JNmeca/Jorge-Nicolas-2019-8448-Electiva-Mecatronica/Resume/ModBus.jpeg

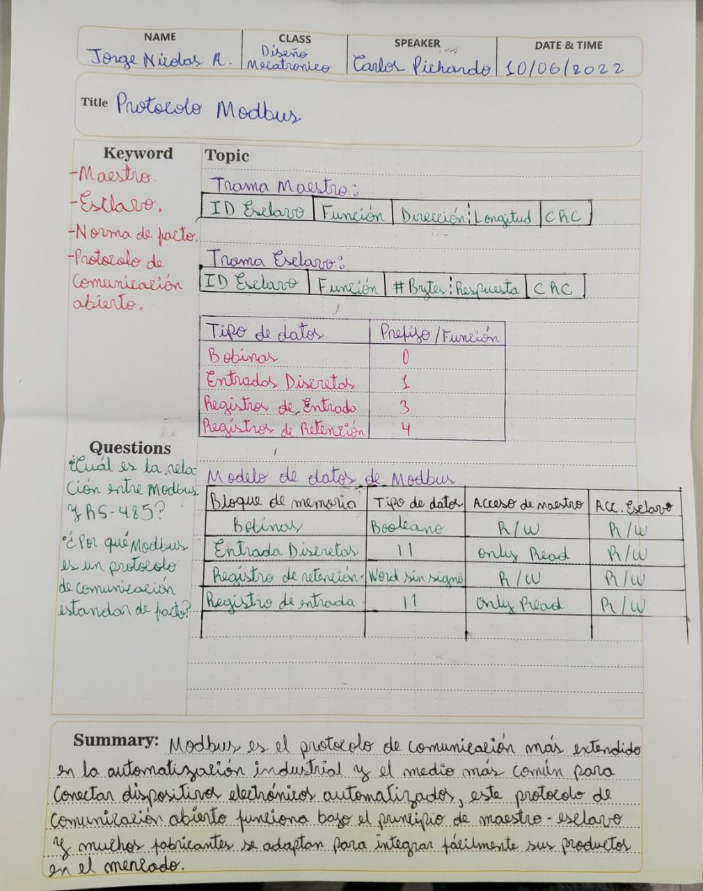
Resume/ModBus.jpeg
