JNmeca/Jorge-Nicolas-2019-8448-Electiva-Mecatronica/Resume/Qg en los MOSFET.jpeg

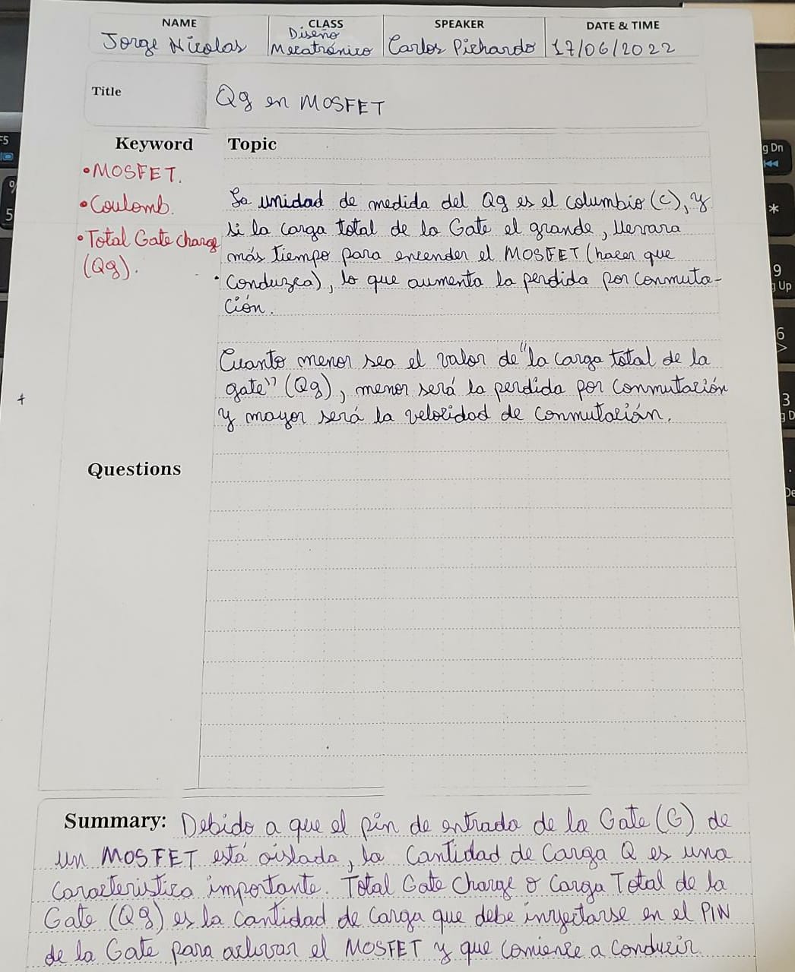
Resume/Qg en los MOSFET.jpeg
