JNmeca/Jorge-Nicolas-2019-8448-Electiva-Mecatronica/Resume/Baudio - BPS.jpeg

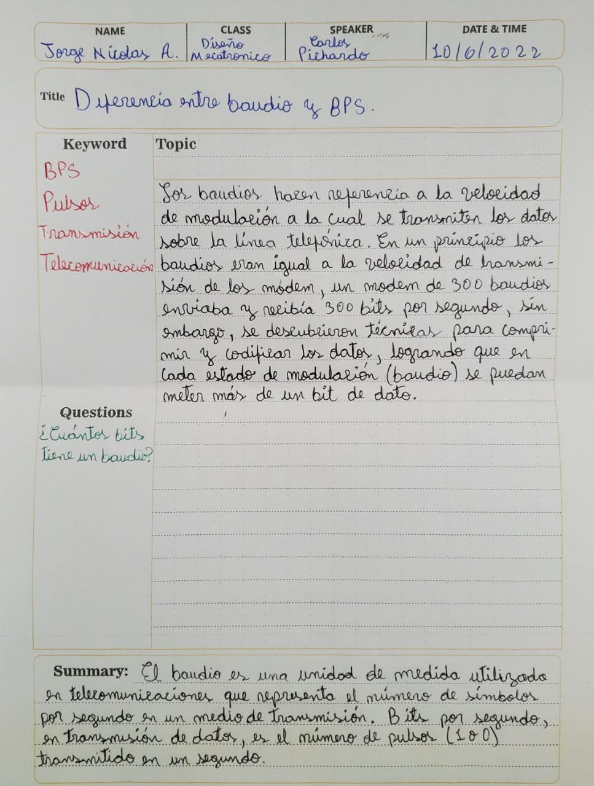
Resume/Baudio - BPS.jpeg
