JNmeca/Jorge-Nicolas-2019-8448-Electiva-Mecatronica/Resume/Dieléctrico en los capacitores.jpeg

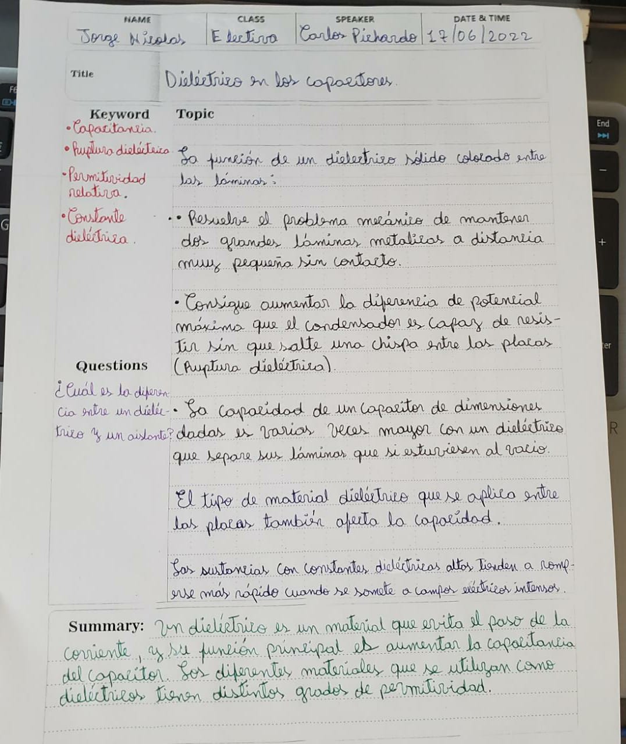
Resume/Dieléctrico en los capacitores.jpeg
