JNmeca/Jorge-Nicolas-2019-8448-Electiva-Mecatronica/Resume/ESR.jpeg

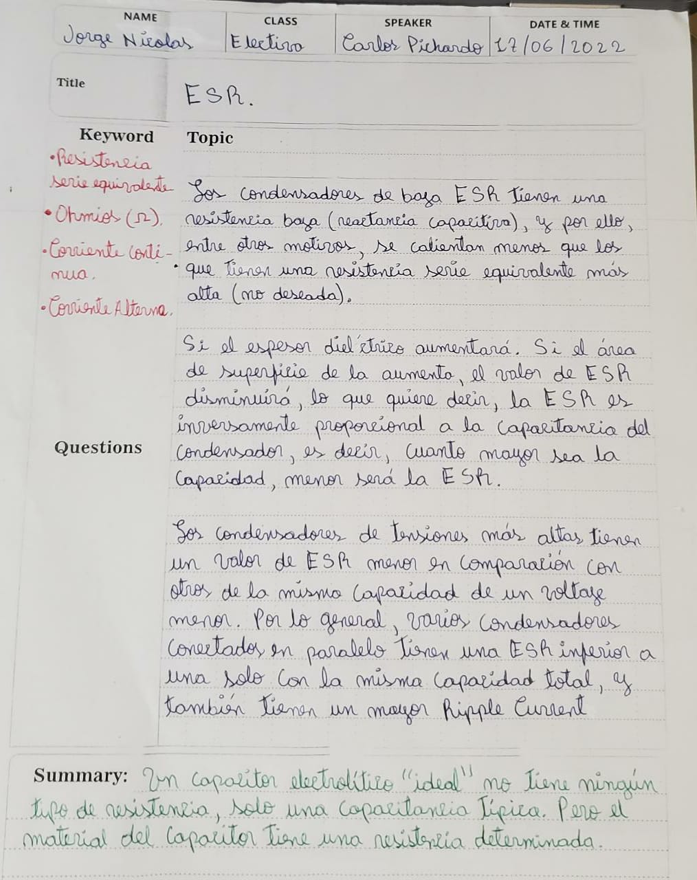
Resume/ESR.jpeg
