JNmeca/Jorge-Nicolas-2019-8448-Electiva-Mecatronica/Resume/GIT.jpeg

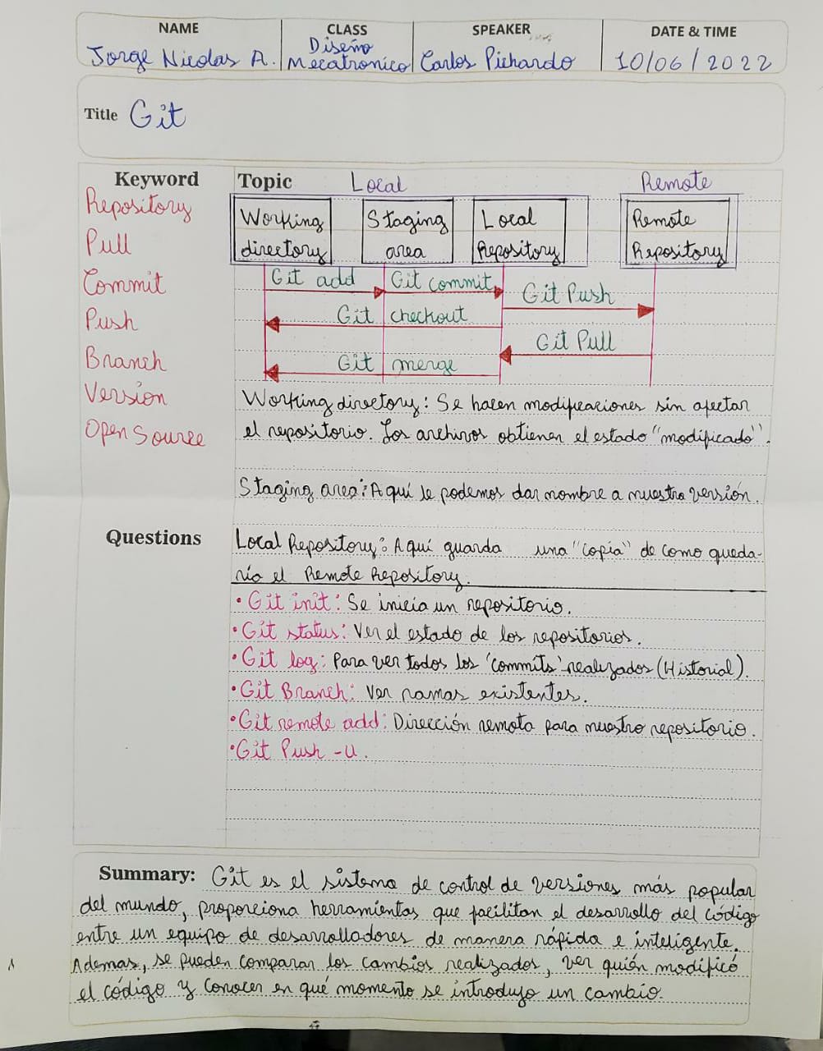
Resume/GIT.jpeg
