JNmeca/Jorge-Nicolas-2019-8448-Electiva-Mecatronica/Resume/Ripple Current.jpeg

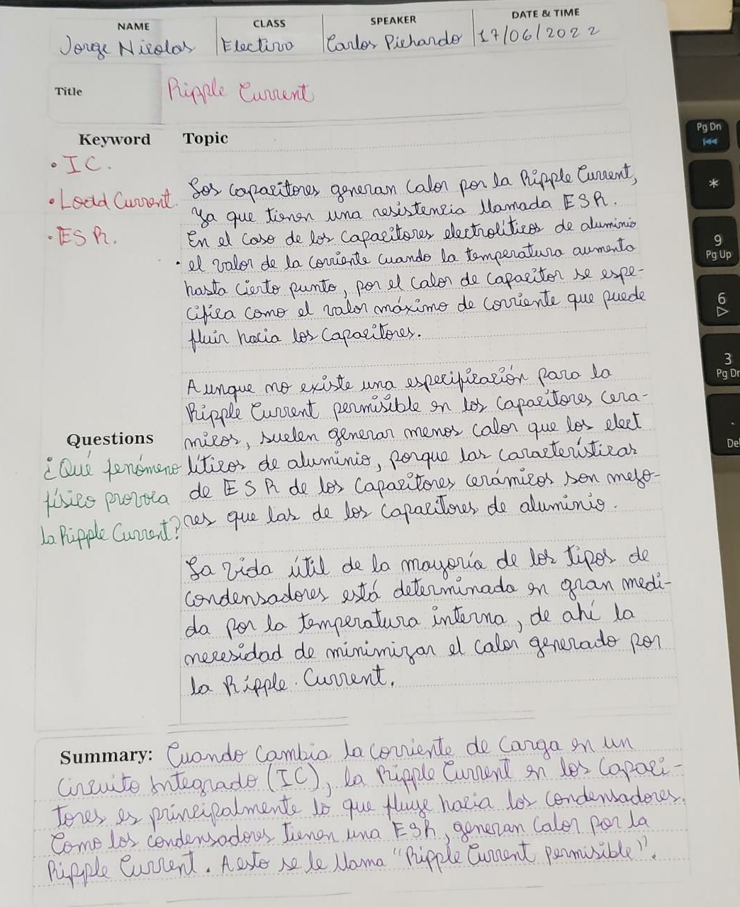
Resume/Ripple Current.jpeg
