JNmeca/Jorge-Nicolas-2019-8448-Electiva-Mecatronica/Resume/RS-485.jpeg

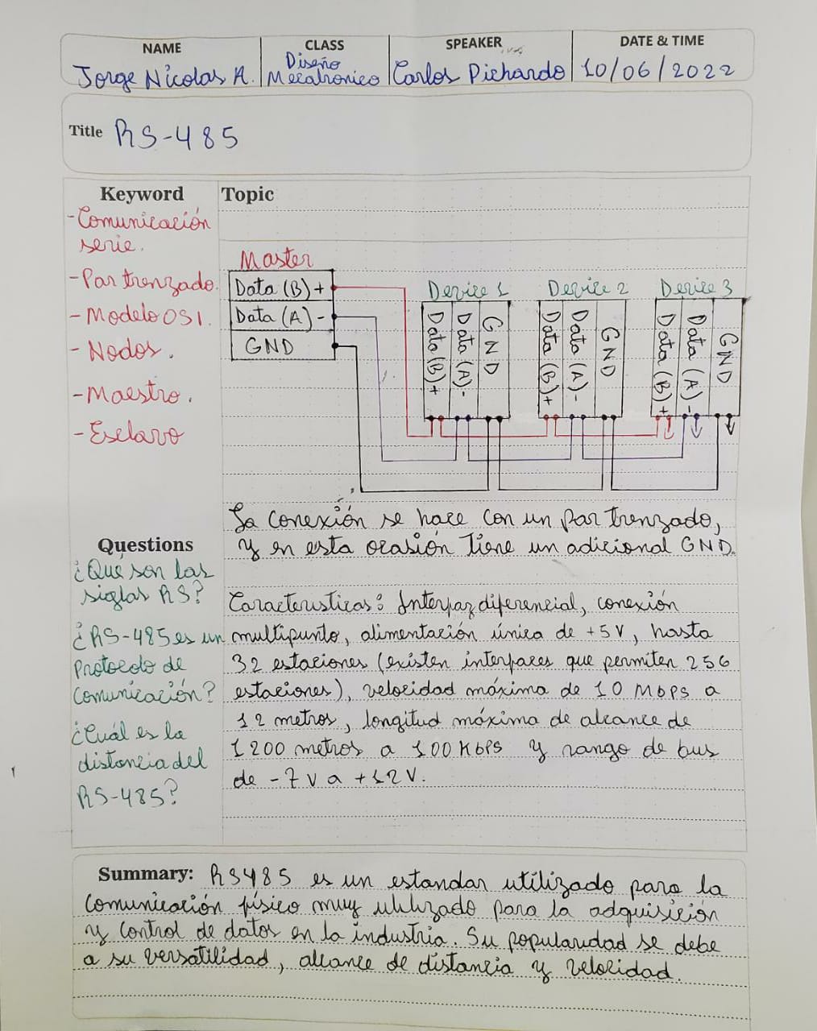
Resume/RS-485.jpeg
