JNmeca/Jorge-Nicolas-2019-8448-Electiva-Mecatronica/Resume/Temperatura en los capacitores.jpeg

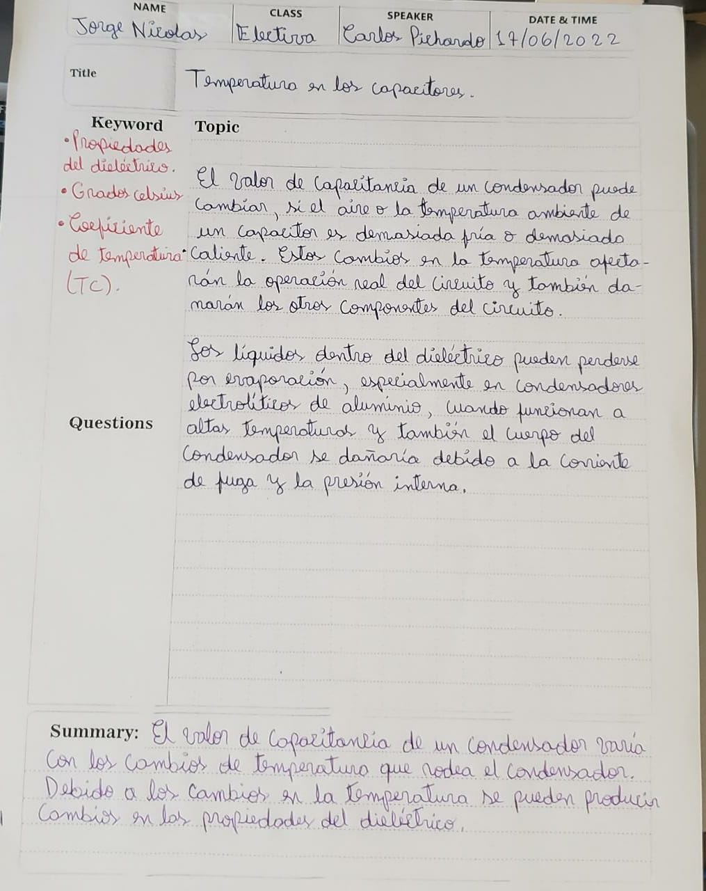
Resume/Temperatura en los capacitores.jpeg
