JNmeca/Jorge-Nicolas-2019-8448-Electiva-Mecatronica/282837-2--3DModel-STEP-1.STEP

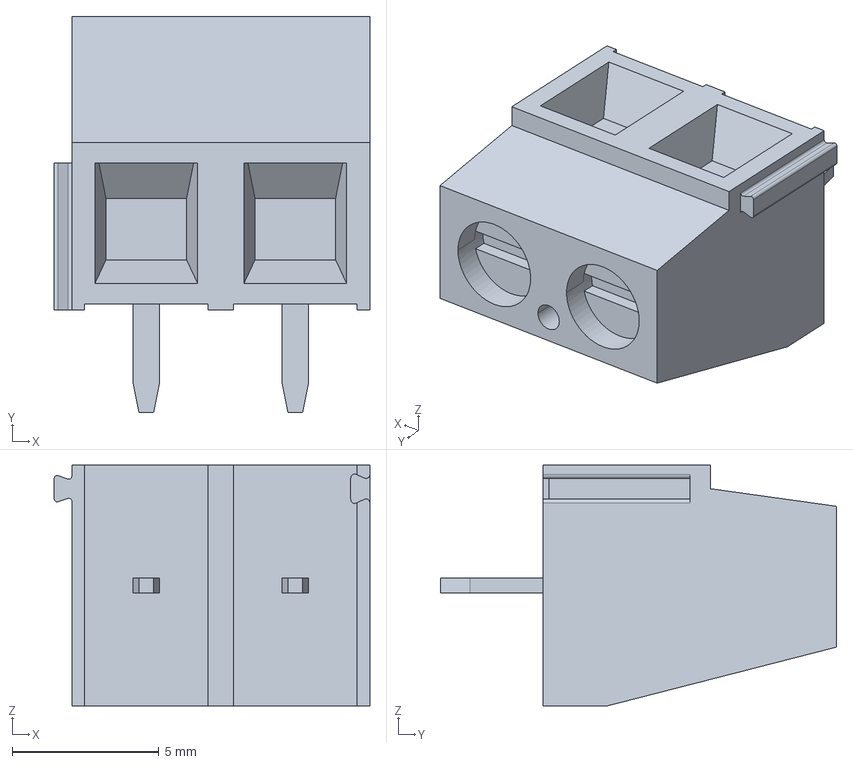
[picture p11: CAD file, 2022-07-15]
282837-2--3DModel-STEP-1.STEP
10.8 x 13.5 x 8.20 mm
