JNmeca/Jorge-Nicolas-2019-8448-Electiva-Mecatronica/691216510003s.stp

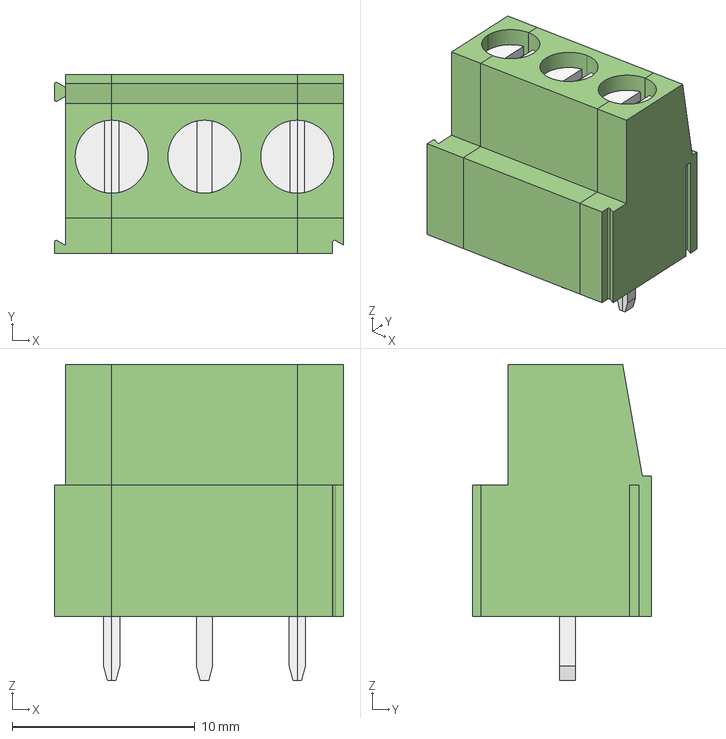
[picture p12: CAD file, 2022-07-15]
691216510003s.stp
15.8 x 9.80 x 17.3 mm
