JNmeca/Jorge-Nicolas-2019-8448-Electiva-Mecatronica/Proyecto Final (PCB)/Proyecto Final.kicad_pcb

## KiCad design Proyecto Final (PCB)/Proyecto Final.kicad_pcb (2022-08-25)

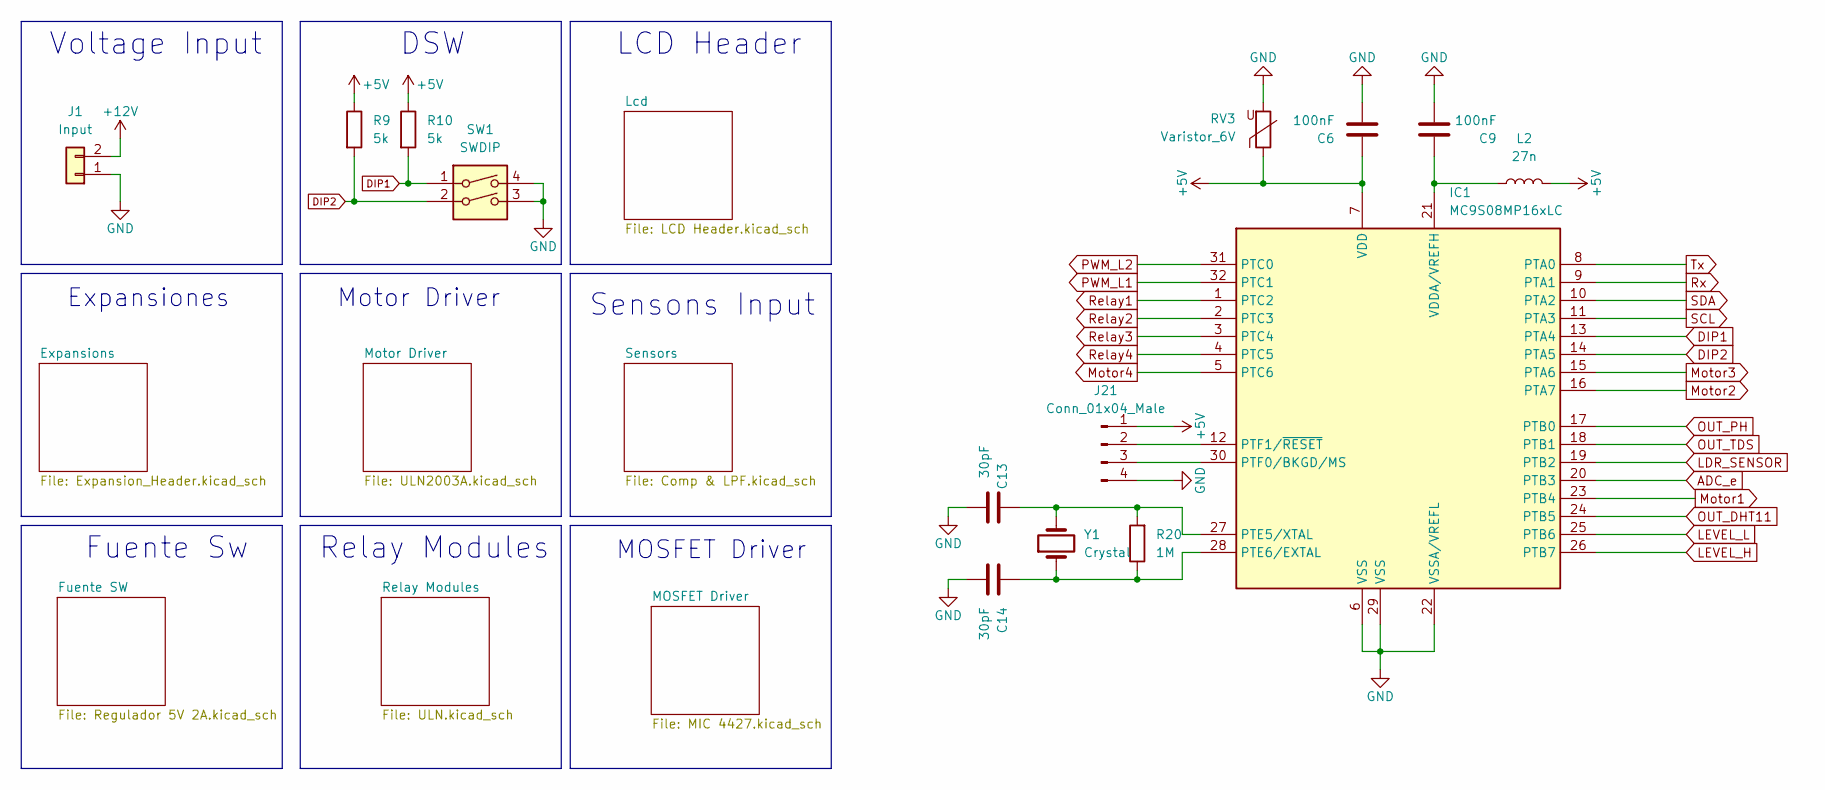
[picture p13: schematic Proyecto Final.kicad_sch]

Parts:
C6, C9: 100nF; C_0603_1608Metric
C13, C14: 30pF; C_0603_1608Metric
IC1: MC9S08MP16xLC; LQFP-32_7x7mm_P0.8mm
J1: Input; TerminalBlock_bornier-2_P5.08mm
J21: Conn_01x04_Male; PinHeader_1x04_P2.54mm_Vertical
L2: 27n; L_0805_2012Metric
R9, R10: 5k; R_0603_1608Metric
R20: 1M; R_0201_0603Metric
RV3: Varistor_6V; C_0805_2012Metric
SW1: SWDIP; SW_DIP_SPSTx02_Slide_9.78x7.26mm_W7.62mm_P2.54mm
Y1: Crystal; Crystal_HC49-4H_Vertical

Connections:
+5V: C6.2, IC1.7 (VDD), J21.1, L2.2, R9.1, R10.1, RV3.1; also elsewhere on the board
+12V: J1.2; also elsewhere on the board
ADC_e: IC1.20 (PTB3); also elsewhere on the board
DIP1: IC1.13 (PTA4), R10.2, SW1.1
DIP2: IC1.14 (PTA5), R9.2, SW1.2
GND: C6.1, C9.1, C13.1, C14.1, IC1.6 (VSS), IC1.22 (VSSA/VREFL), IC1.29 (VSS), J1.1, J21.4, RV3.2, SW1.3, SW1.4; also elsewhere on the board
LDR_SENSOR: IC1.19 (PTB2); also elsewhere on the board
LEVEL_H: IC1.26 (PTB7); also elsewhere on the board
LEVEL_L: IC1.25 (PTB6); also elsewhere on the board
Motor1: IC1.23 (PTB4); also elsewhere on the board
Motor2: IC1.16 (PTA7); also elsewhere on the board
Motor3: IC1.15 (PTA6); also elsewhere on the board
Motor4: IC1.5 (PTC6); also elsewhere on the board
unnamed: C9.2, IC1.21 (VDDA/VREFH), L2.1
unnamed: C13.2, IC1.27 (PTE5/XTAL), R20.2, Y1.2
unnamed: C14.2, IC1.28 (PTE6/EXTAL), R20.1, Y1.1
unnamed: IC1.12 (PTF1/~RESET), J21.2
unnamed: IC1.30 (PTF0/BKGD/MS), J21.3
OUT_DHT11: IC1.24 (PTB5); also elsewhere on the board
OUT_PH: IC1.17 (PTB0); also elsewhere on the board
OUT_TDS: IC1.18 (PTB1); also elsewhere on the board
PWM_L1: IC1.32 (PTC1); also elsewhere on the board
PWM_L2: IC1.31 (PTC0); also elsewhere on the board
Relay1: IC1.1 (PTC2); also elsewhere on the board
Relay2: IC1.2 (PTC3); also elsewhere on the board
Relay3: IC1.3 (PTC4); also elsewhere on the board
Relay4: IC1.4 (PTC5); also elsewhere on the board
Rx: IC1.9 (PTA1); also elsewhere on the board
SCL: IC1.11 (PTA3); also elsewhere on the board
SDA: IC1.10 (PTA2); also elsewhere on the board
Tx: IC1.8 (PTA0); also elsewhere on the board

Notes on the sheet:
DSW
Expansiones
LCD Header
Motor Driver
MOSFET Driver
Voltage Input
Sensons Input
Fuente Sw
Relay Modules

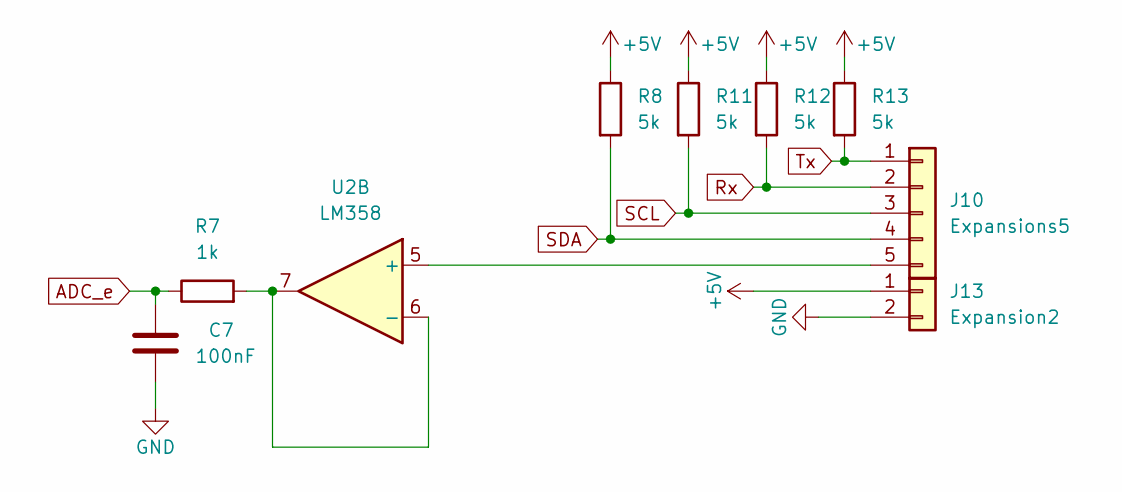
[picture p14: schematic Expansion_Header.kicad_sch]

Parts:
C7: 100nF; C_0603_1608Metric
J10: Expansions5; TerminalBlock_bornier-5_P5.08mm
J13: Expansion2; TerminalBlock_bornier-2_P5.08mm
R7: 1k; R_0603_1608Metric
R8, R11, R12, R13: 5k; R_0603_1608Metric
U2: LM358; SOIC-8_3.9x4.9mm_P1.27mm

Connections:
+5V: J13.1, R8.1, R11.1, R12.1, R13.1; also elsewhere on the board
ADC_e: C7.1, R7.1; also elsewhere on the board
GND: C7.2, J13.2; also elsewhere on the board
unnamed 41: J10.5, U2.5 (+); also elsewhere on the board
unnamed: R7.2, U2.6 (-), U2.7
Rx: J10.2, R12.2; also elsewhere on the board
SCL: J10.3, R11.2; also elsewhere on the board
SDA: J10.4, R8.2; also elsewhere on the board
Tx: J10.1, R13.2; also elsewhere on the board

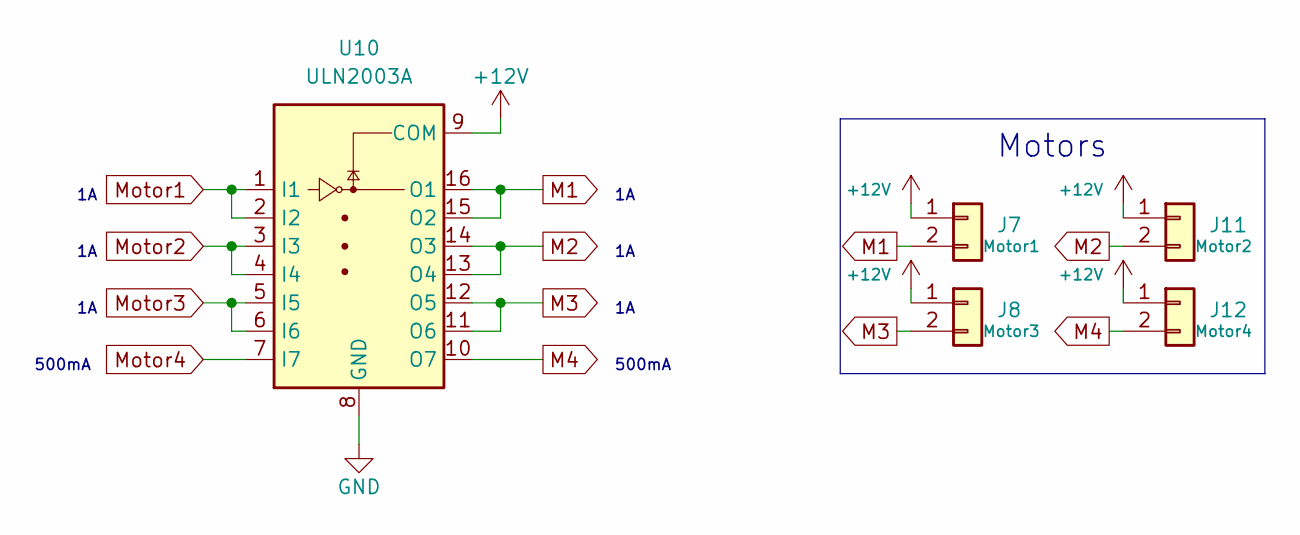
[picture p15: schematic ULN2003A.kicad_sch]

Parts:
J7: Motor1; TerminalBlock_bornier-2_P5.08mm
J8: Motor3; TerminalBlock_bornier-2_P5.08mm
J11: Motor2; TerminalBlock_bornier-2_P5.08mm
J12: Motor4; TerminalBlock_bornier-2_P5.08mm
U10: ULN2003A; SOIC-16_3.9x9.9mm_P1.27mm

Connections:
+12V: J7.1, J8.1, J11.1, J12.1, U10.9 (COM); also elsewhere on the board
GND: U10.8 (GND); also elsewhere on the board
M1: J7.2, U10.15 (O2), U10.16 (O1)
M2: J11.2, U10.13 (O4), U10.14 (O3)
M3: J8.2, U10.11 (O6), U10.12 (O5)
M4: J12.2, U10.10 (O7)
Motor1: U10.1 (I1), U10.2 (I2); also elsewhere on the board
Motor2: U10.3 (I3), U10.4 (I4); also elsewhere on the board
Motor3: U10.5 (I5), U10.6 (I6); also elsewhere on the board
Motor4: U10.7 (I7); also elsewhere on the board

Notes on the sheet:
500mA
Motors

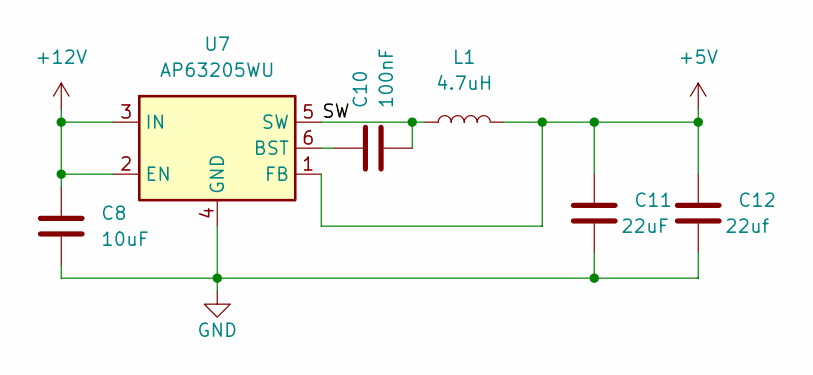
[picture p16: schematic Regulador 5V 2A.kicad_sch]

Parts:
C8: 10uF; C_0805_2012Metric
C10: 100nF; C_0201_0603Metric
C11: 22uF; C_0805_2012Metric
C12: 22uf; C_0805_2012Metric
L1: 4.7uH; L_Bourns_SRN6045TA
U7: AP63205WU; TSOT-23-6

Connections:
+5V: C11.1, C12.1, L1.2, U7.1 (FB); also elsewhere on the board
+12V: C8.1, U7.2 (EN), U7.3 (IN); also elsewhere on the board
/Fuente SW/SW: C10.1, L1.1, U7.5 (SW)
GND: C8.2, C11.2, C12.2, U7.4 (GND); also elsewhere on the board
unnamed: C10.2, U7.6 (BST)

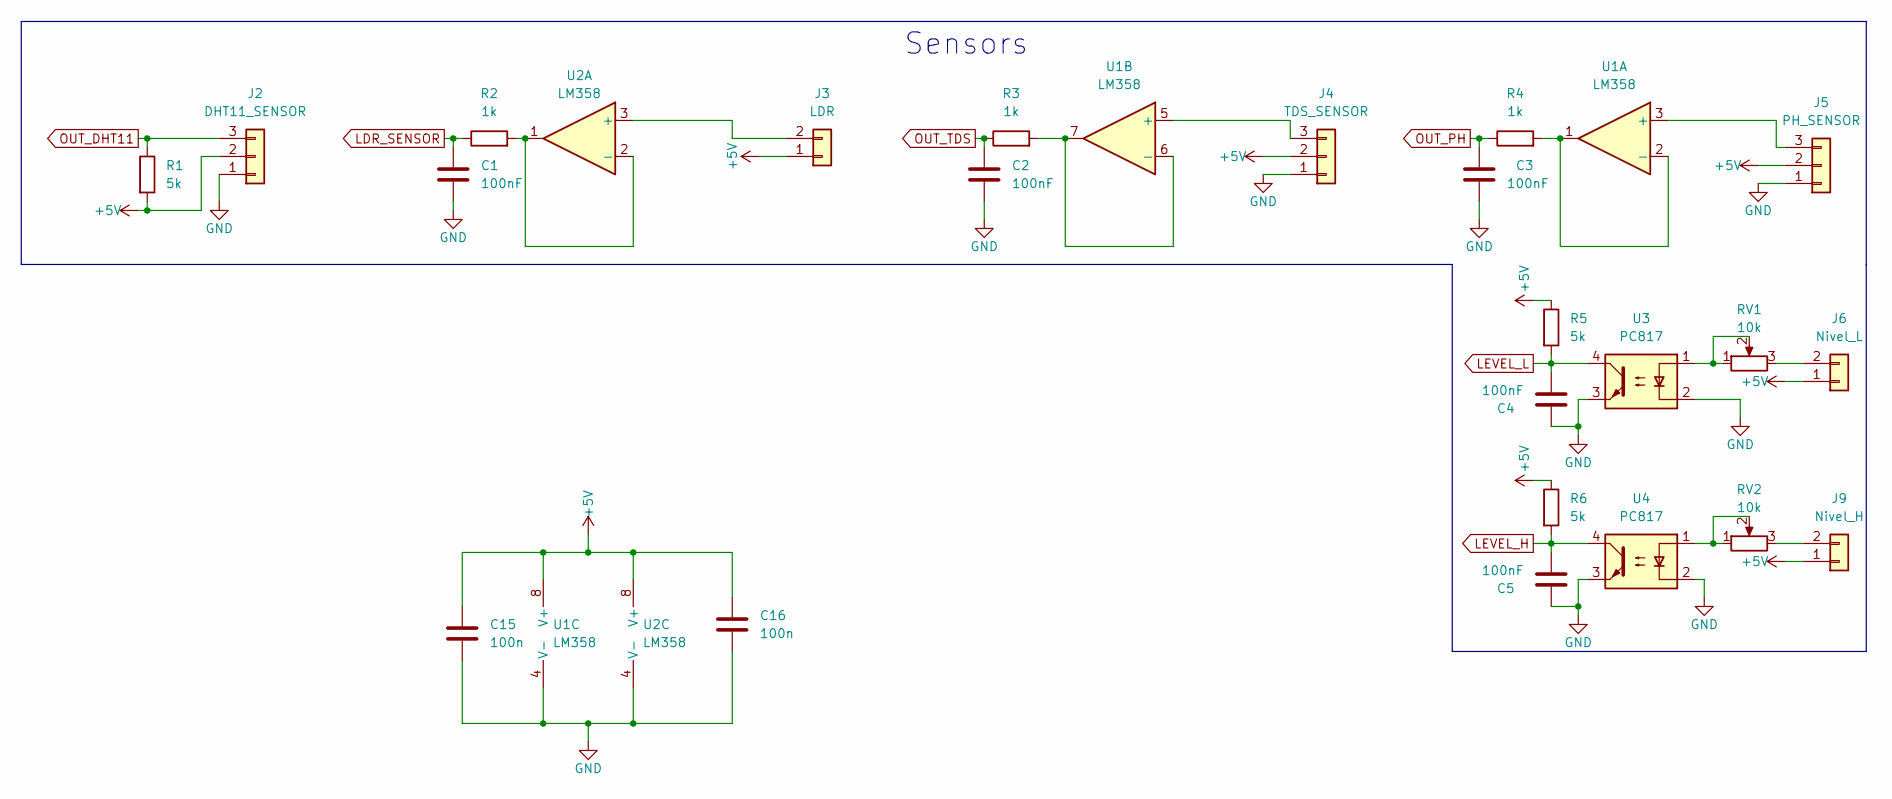
[picture p17: schematic Comp & LPF.kicad_sch]

Parts:
C1, C2, C3, C4, C5: 100nF; C_0603_1608Metric
C15, C16: 100n; C_0201_0603Metric
J2: DHT11_SENSOR; TerminalBlock_bornier-3_P5.08mm
J3: LDR; TerminalBlock_bornier-2_P5.08mm
J4: TDS_SENSOR; TerminalBlock_bornier-3_P5.08mm
J5: PH_SENSOR; TerminalBlock_bornier-3_P5.08mm
J6: Nivel_L; TerminalBlock_bornier-2_P5.08mm
J9: Nivel_H; TerminalBlock_bornier-2_P5.08mm
R1, R5, R6: 5k; R_0603_1608Metric
R2, R3, R4: 1k; R_0603_1608Metric
RV1, RV2: 10k; Potentiometer_Bourns_3266Y_Vertical
U1, U2: LM358; SOIC-8_3.9x4.9mm_P1.27mm
U3, U4: PC817; DIP-4_W7.62mm

Connections:
+5V: C15.1, C16.1, J2.2, J3.1, J4.2, J5.2, J6.1, J9.1, R1.2, R5.1, R6.1, U1.8 (V+), U2.8 (V+); also elsewhere on the board
GND: C1.2, C2.2, C3.2, C4.1, C5.1, C15.2, C16.2, J2.1, J4.1, J5.1, U1.4 (V-), U2.4 (V-), U3.2, U3.3, U4.2, U4.3; also elsewhere on the board
LDR_SENSOR: C1.1, R2.1; also elsewhere on the board
LEVEL_H: C5.2, R6.2, U4.4; also elsewhere on the board
LEVEL_L: C4.2, R5.2, U3.4; also elsewhere on the board
unnamed: J3.2, U2.3 (+)
unnamed: J4.3, U1.5 (+)
unnamed: J5.3, U1.3 (+)
unnamed: J6.2, RV1.3
unnamed: J9.2, RV2.3
unnamed: R2.2, U2.1, U2.2 (-)
unnamed: R3.2, U1.6 (-), U1.7
unnamed: R4.2, U1.1, U1.2 (-)
unnamed: RV1.1, RV1.2, U3.1
unnamed: RV2.1, RV2.2, U4.1
OUT_DHT11: J2.3, R1.1; also elsewhere on the board
OUT_PH: C3.1, R4.1; also elsewhere on the board
OUT_TDS: C2.1, R3.1; also elsewhere on the board

Notes on the sheet:
Sensors

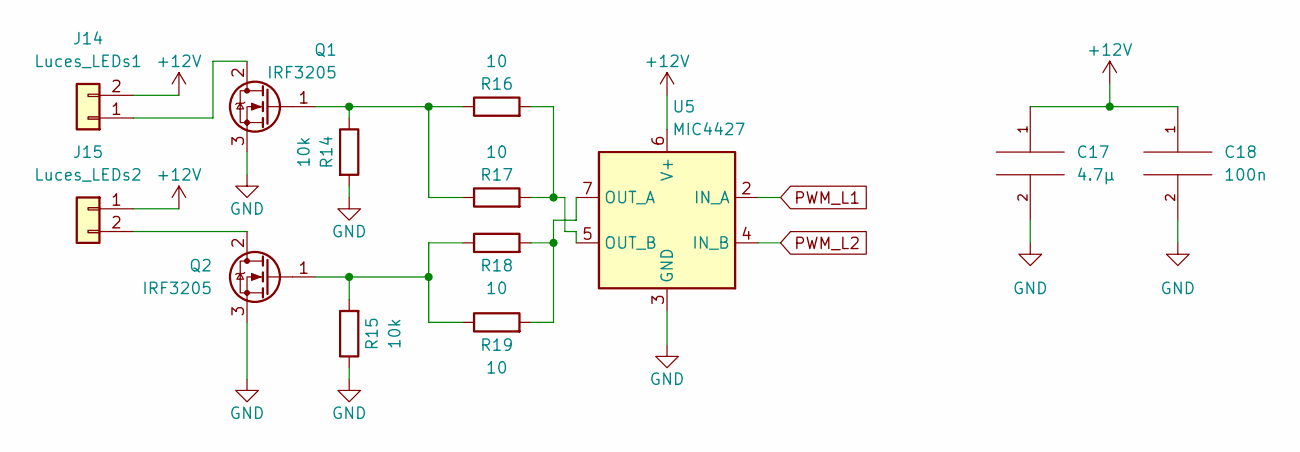
[picture p18: schematic MIC 4427.kicad_sch]

Parts:
C17: 4.7µ; C_0805_2012Metric
C18: 100n; C_0201_0603Metric
J14: Luces_LEDs1; TerminalBlock_bornier-2_P5.08mm
J15: Luces_LEDs2; TerminalBlock_bornier-2_P5.08mm
Q1, Q2: IRF3205; TO-220-3_Vertical
R14, R15: 10k; R_0603_1608Metric
R16, R17, R18, R19: 10; R_0603_1608Metric
U5: MIC4427; SOIC-8_3.9x4.9mm_P1.27mm

Connections:
+12V: C17.1, C18.1, J14.2, J15.1, U5.6 (V+); also elsewhere on the board
GND: C17.2, C18.2, Q1.3 (S), Q2.3 (S), R14.2, R15.1, U5.3 (GND); also elsewhere on the board
unnamed: J14.1, Q1.2 (D)
unnamed: J15.2, Q2.2 (D)
unnamed: Q1.1 (G), R14.1, R16.1, R17.1
unnamed: Q2.1 (G), R15.2, R18.1, R19.1
unnamed: R16.2, R17.2, U5.5 (OUT_B)
unnamed: R18.2, R19.2, U5.7 (OUT_A)
PWM_L1: U5.2 (IN_A); also elsewhere on the board
PWM_L2: U5.4 (IN_B); also elsewhere on the board

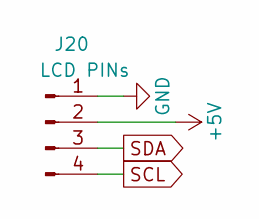
[picture p19: schematic LCD Header.kicad_sch]

Parts:
J20: LCD PINs; PinHeader_1x04_P2.54mm_Vertical

Connections:
+5V: J20.2; also elsewhere on the board
GND: J20.1; also elsewhere on the board
SCL: J20.4; also elsewhere on the board
SDA: J20.3; also elsewhere on the board

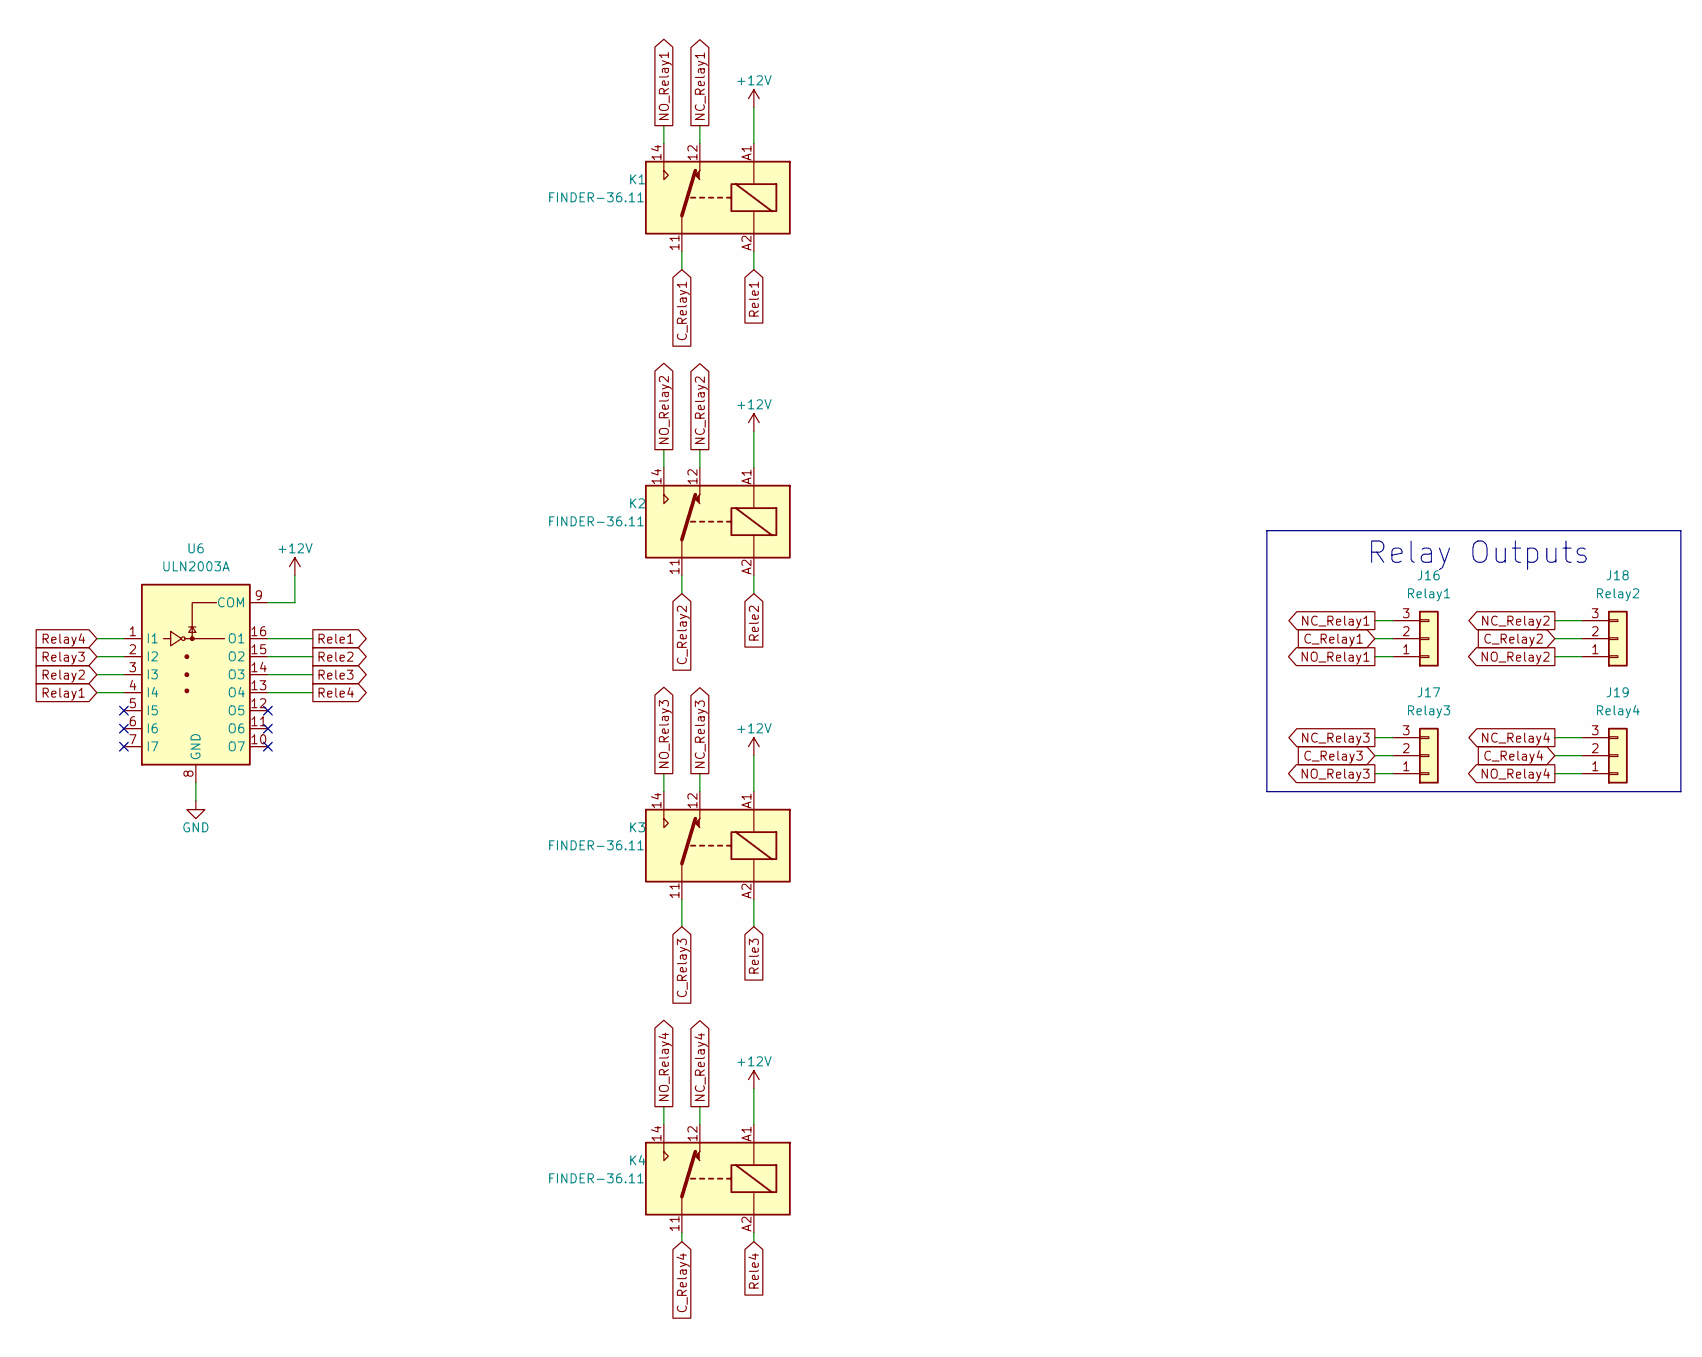
[picture p20: schematic ULN.kicad_sch]

Parts:
J16: Relay1; TerminalBlock_bornier-3_P5.08mm
J17: Relay3; TerminalBlock_bornier-3_P5.08mm
J18: Relay2; TerminalBlock_bornier-3_P5.08mm
J19: Relay4; TerminalBlock_bornier-3_P5.08mm
K1, K2, K3, K4: FINDER-36.11; Relay_SPDT_Finder_36.11
U6: ULN2003A; SOIC-16_3.9x9.9mm_P1.27mm

Connections:
+12V: K1.A1, K2.A1, K3.A1, K4.A1, U6.9 (COM); also elsewhere on the board
C_Relay1: J16.2, K1.11
C_Relay2: J18.2, K2.11
C_Relay3: J17.2, K3.11
C_Relay4: J19.2, K4.11
GND: U6.8 (GND); also elsewhere on the board
NC_Relay1: J16.3, K1.12
NC_Relay2: J18.3, K2.12
NC_Relay3: J17.3, K3.12
NC_Relay4: J19.3, K4.12
NO_Relay1: J16.1, K1.14
NO_Relay2: J18.1, K2.14
NO_Relay3: J17.1, K3.14
NO_Relay4: J19.1, K4.14
Relay1: U6.4 (I4); also elsewhere on the board
Relay2: U6.3 (I3); also elsewhere on the board
Relay3: U6.2 (I2); also elsewhere on the board
Relay4: U6.1 (I1); also elsewhere on the board
Rele1: K1.A2, U6.16 (O1)
Rele2: K2.A2, U6.15 (O2)
Rele3: K3.A2, U6.14 (O3)
Rele4: K4.A2, U6.13 (O4)

Notes on the sheet:
Relay Outputs

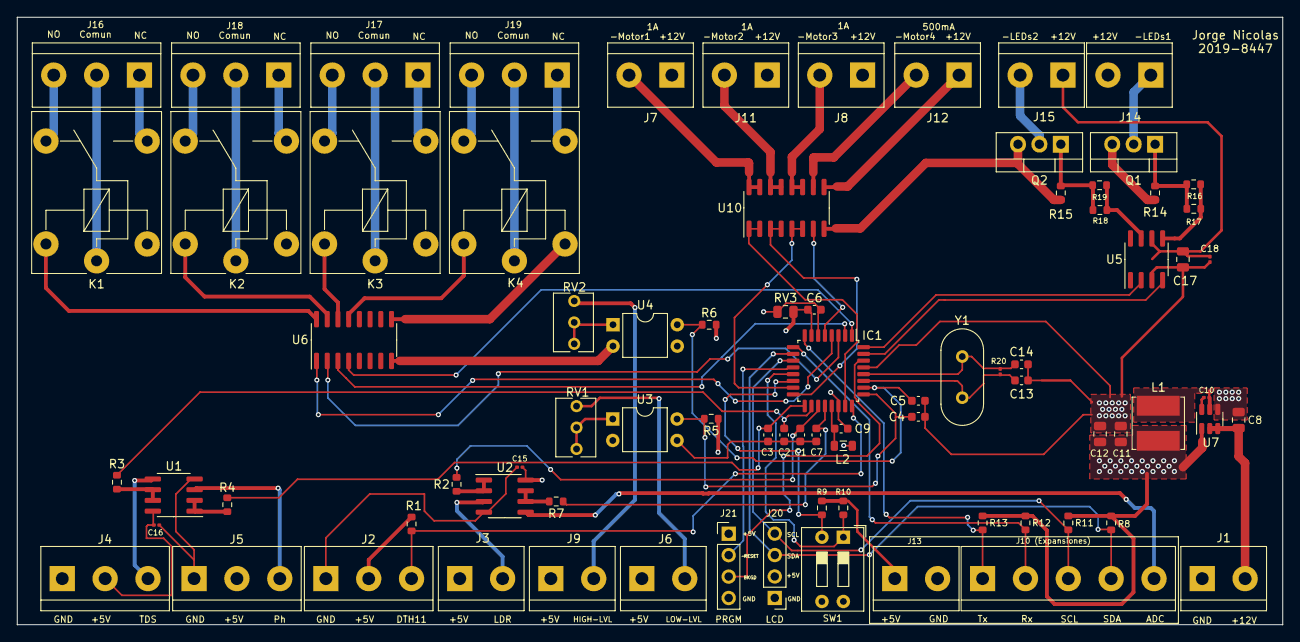
[picture p21: board Proyecto Final.kicad_pcb from above]

Board: 4 copper layers, 150.0 x 72.0 mm, 81 parts (0 on the bottom side), 71 nets.

Other parts of the board:
J10 (Expansiones): Expansions5; TerminalBlock_bornier-5_P5.08mm

Their connections:
unnamed 41: J10 (Expansiones).5; also elsewhere on the board
Rx: J10 (Expansiones).2; also elsewhere on the board
SCL: J10 (Expansiones).3; also elsewhere on the board
SDA: J10 (Expansiones).4; also elsewhere on the board
Tx: J10 (Expansiones).1; also elsewhere on the board
