JNmeca/Jorge-Nicolas-2019-8448-Electiva-Mecatronica/(commit log)

2022-07-15 Corrección en el aula
    [Comp & LPF.kicad_sch, Proyecto Final.kicad_pcb, Regulador 5V 2A.kicad_sch]
2022-07-22 22/07/2022 AULA
    [Proyecto Final.kicad_pcb]
